bandolibre/bandolibre.github.io/models/BandoNeo - Key - 72.3mf

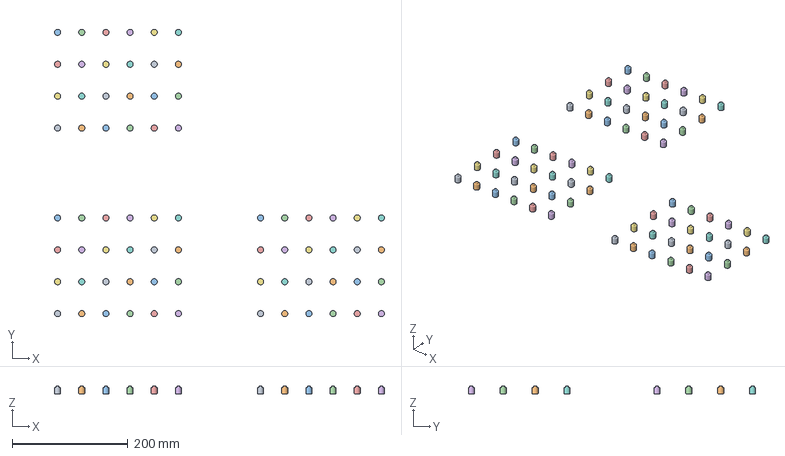
[picture p9: CAD file, 2026-06-30]
models/BandoNeo - Key - 72.3mf
569.0 x 495.7 x 14.0 mm
