bandolibre/bandolibre.github.io/models/BandoNeo - Key - slice.3mf

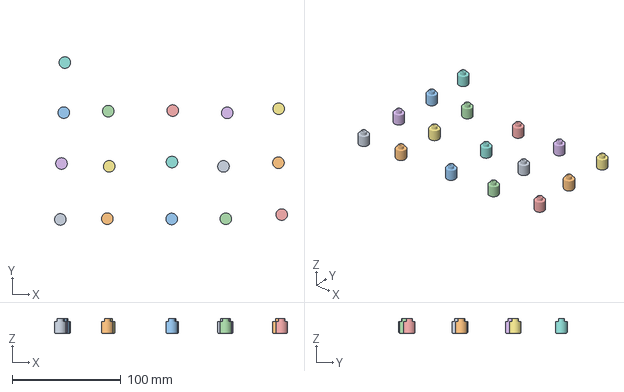
[picture p10: CAD file, 2026-06-30]
models/BandoNeo - Key - slice.3mf
214.0 x 154.8 x 14.0 mm
