bandolibre/bandolibre.github.io/code/main-g474/Core/Src/main.c

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
/* Includes ------------------------------------------------------------------*/
#include "main.h"

/* USER CODE BEGIN Includes */
#include <stdio.h>
#include <stdlib.h>
#include <string.h>
#include "console.h"
#include "swo.h"
#include "usb_app.h"
#include "app/bellow.h"
#include "app/buttons.h"
#include "app/keyboard.h"
#include "app/pedals.h"
#include "app/report.h"
#include "properties.h"
#include "properties_console.h"
#include "app/midi.h"
#include "app/app.h"

/* USER CODE END Includes */

ADC_HandleTypeDef hadc1;
ADC_HandleTypeDef hadc2;
ADC_HandleTypeDef hadc3;
ADC_HandleTypeDef hadc4;

SPI_HandleTypeDef hspi1;
SPI_HandleTypeDef hspi2;
DMA_HandleTypeDef hdma_spi1_rx;
DMA_HandleTypeDef hdma_spi2_rx;

UART_HandleTypeDef huart1;

PCD_HandleTypeDef hpcd_USB_FS;

void SystemClock_Config(void);
static void MX_GPIO_Init(void);
static void MX_DMA_Init(void);
static void MX_ADC1_Init(void);
static void MX_ADC2_Init(void);
static void MX_ADC3_Init(void);
static void MX_ADC4_Init(void);
static void MX_SPI1_Init(void);
static void MX_SPI2_Init(void);
static void MX_USART1_UART_Init(void);
static void MX_USB_PCD_Init(void);
/* USER CODE BEGIN 0 */

int console_execute(int argc, const char * const *argv)
{
  if (argc == 0)
    return 0;
  /* microrl ends the input line with LF only (no CR), leaving the cursor under
   * the command text. Return to column 0 so output prints cleanly below the
   * preserved "IRin > <cmd>" line instead of overwriting it. */
  printf("\r\n");
  if (strcmp(argv[0], "hello") == 0)
  {
    printf("Hello, Bandolibre!\r\n");
  }
  else if (strcmp(argv[0], "midi") == 0)
  {
    /* midi [note]: send a test note on/off pair over USB MIDI (default A4) */
    uint8_t note = (argc > 1) ? (uint8_t)atoi(argv[1]) : 69;
    usb_app_midi_test_note(note);
    printf("Sent MIDI note %u on/off\r\n", note);
  }
  else if (strcmp(argv[0], "bellow_tune") == 0) bellow_tune();
  else if (strcmp(argv[0], "help") == 0)   { properties_help(); midi_console_help(); }
  else if (properties_execute(argc, argv)) { /* handled show/get/set/reset */ }
  else if (midi_console_execute(argc, argv)) { /* handled a send_* command */ }
  else
    printf("Unknown command: %s (try 'help')\r\n", argv[0]);
  return 0;
}

/* Tab-completion for microrl: completes the command word, and the property name
 * argument of get/set/reset. Returns a NULL-terminated array of full tokens.
 * property_complete() caps its output at the buffer size, so growth is safe. */
#define CONSOLE_COMPL_MAX 32
char ** console_complete(int argc, const char * const *argv)
{
  static const char *commands[] = { "help", "show", "get", "set", "reset", "hello", "midi", "bellow_tune" };
  static char *out[CONSOLE_COMPL_MAX + 1];
  const char *partial = (argc > 0) ? argv[argc - 1] : "";
  size_t n = 0;

  if (argc <= 1)
  {
    size_t plen = strlen(partial);
    for (size_t i = 0; i < sizeof(commands) / sizeof(commands[0]); i++)
      if (strncmp(commands[i], partial, plen) == 0)
        out[n++] = (char *)commands[i];
    const char *midi[CONSOLE_COMPL_MAX];
    size_t m = midi_console_complete(partial, midi, CONSOLE_COMPL_MAX - n);
    for (size_t i = 0; i < m; i++)
      out[n++] = (char *)midi[i];
  }
  else if (argc == 2 && (strcmp(argv[0], "get") == 0 ||
                         strcmp(argv[0], "set") == 0 ||
                         strcmp(argv[0], "reset") == 0))
  {
    const char *names[CONSOLE_COMPL_MAX];
    size_t m = properties_complete(partial, names, CONSOLE_COMPL_MAX);
    for (size_t i = 0; i < m; i++)
      out[n++] = (char *)names[i];
  }
  out[n] = NULL;
  return out;
}

/* USER CODE END 0 */

/**
  * @brief  The application entry point.
  * @retval int
  */
int main(void)
{

  /* MCU Configuration--------------------------------------------------------*/

  /* Reset of all peripherals, Initializes the Flash interface and the Systick. */
  HAL_Init();

  /* Configure the system clock */
  SystemClock_Config();

  /* Initialize all configured peripherals */
  MX_GPIO_Init();
  MX_DMA_Init();
  MX_ADC1_Init();
  MX_ADC2_Init();
  MX_ADC3_Init();
  MX_ADC4_Init();
  MX_SPI1_Init();
  MX_SPI2_Init();
  MX_USART1_UART_Init();
  MX_USB_PCD_Init();
  /* USER CODE BEGIN 2 */
  main_init();
  /* USER CODE END 2 */

  /* Infinite loop */
  /* USER CODE BEGIN WHILE */
  while (1)
  {
    /* USER CODE END WHILE */

    /* USER CODE BEGIN 3 */
    main_task();
  }
  /* USER CODE END 3 */
}

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
