bandolibre/bandolibre.github.io/code/main-g474/main-g474.ioc

Mcu.UserName=STM32G474CBTx
PA0.GPIO_Label=EXP_PEDAL
PA0.Signal=ADC1_IN1
PA1.GPIO_Label=SUS_PEDAL
PA1.Signal=ADC2_IN2
PA10.Signal=USART1_RX
PA11.GPIO_Label=USB_DM
PA11.Signal=USB_DM
PA12.GPIO_Label=USB_DP
PA12.Signal=USB_DP
PA13.Signal=SYS_JTMS-SWDIO
PA14.Signal=SYS_JTCK-SWCLK
PA15.GPIO_Label=PGM_DETECT
PA15.Signal=GPIO_Input
PA2.GPIO_Label=HALL_NEN
PA2.Signal=GPIO_Output
PA3.GPIO_Label=L_BOOT0
PA3.Signal=GPIO_Output
PA4.GPIO_Label=L_SPI_NSS
PA4.Signal=SPI1_NSS
PA5.GPIO_Label=L_SPI_SCK
PA5.Signal=SPI1_SCK
PA6.GPIO_Label=L_SPI_MISO
PA6.Signal=SPI1_MISO
PA7.GPIO_Label=L_SPI_MOSI
PA7.Signal=SPI1_MOSI
PA8.GPIO_Label=R_READY
PA8.Signal=GPIO_Input
PA9.Signal=USART1_TX
PB0.GPIO_Label=L_READY
PB0.Signal=GPIO_Input
PB1.GPIO_Label=HALL0
PB1.Signal=ADC3_IN1
PB11.GPIO_Label=R_NRST
PB11.Signal=GPIO_Output
PB12.GPIO_Label=HALL1
PB12.Signal=ADC4_IN3
PB13.GPIO_Label=R_BOOT0
PB13.Signal=GPIO_Output
PB14.GPIO_Label=R_SPI_MISO
PB14.Signal=SPI2_MISO
PB15.GPIO_Label=R_SPI_MOSI
PB15.Signal=SPI2_MOSI
PB2.GPIO_Label=L_NRST
PB2.Signal=GPIO_Output
PB3.Signal=SYS_JTDO-SWO
PB4.GPIO_Label=SW_FN2
PB4.Signal=GPIO_Input
PB5.GPIO_Label=LED_FN2
PB5.Signal=GPIO_Output
PB6.GPIO_Label=SW_FN1
PB6.Signal=GPIO_Input
PB7.GPIO_Label=LED_FN1
PB7.Signal=GPIO_Output
PB8-BOOT0.GPIO_Label=SW_FN0_BOOT0
PB8-BOOT0.Signal=GPIO_Input
PB9.GPIO_Label=LED_FN0
PB9.Signal=GPIO_Output
PC14-OSC32_IN.GPIO_Label=EXP_PEDAL_INT
PC14-OSC32_IN.Signal=GPIO_Input
PC15-OSC32_OUT.GPIO_Label=SUS_PEDAL_INT
PC15-OSC32_OUT.Signal=GPIO_Input
PF0-OSC_IN.GPIO_Label=R_SPI_NSS
PF0-OSC_IN.Signal=SPI2_NSS
PF1-OSC_OUT.GPIO_Label=R_SPI_SCK
PF1-OSC_OUT.Signal=SPI2_SCK
