bandolibre/bandolibre.github.io/code/main-g474/app/pedals.c

#include "pedals.h"

#include <stdio.h>

#include "hysteresis.h"
#include "keyboard.h"   /* L_MIDI_CH / R_MIDI_CH */
#include "main.h"
#include "properties.h"
#include "usb_app.h"

/* ADC handles for the two pedal wipers, defined by the CubeMX-generated main.c:
 * ADC1 reads pedal 1 (expression), ADC2 pedal 2 (sustain). */
extern ADC_HandleTypeDef hadc1;
extern ADC_HandleTypeDef hadc2;

/* Each pedal's wiper is interpolated over its [min,max] property range to 0..127
 * and sent on this controller. Pedal 1 uses Modulation (CC#1) and pedal 2 the
 * Foot Controller (CC#4): both are pre-mapped in most instruments, so the
 * pedals do something out of the box, and either can still be MIDI-learned to a
 * different VST parameter in the DAW. */
#define PEDAL1_CC 1
#define PEDAL2_CC 4

/* Movement of the wiper sample (out of the 12-bit ADC range) that must be
 * exceeded before a new diagnostic line is logged, so wiper noise on a
 * connected pedal doesn't flood the console. */
static const uint32_t PEDAL_WIPER_HYST = 16;

/* Per-pedal state retained across polls: the directional-hysteresis state that
 * cleans the wiper into a 0..127 CC, plus separate state for the diagnostic
 * log line. */
typedef struct {
  hyst_state_t hyst;        /* sample -> CC hysteresis/rate-limit state */
  uint8_t  connected_prev;  /* connected flag at the last logged line (0xFF = none yet) */
  uint32_t sample_prev;     /* wiper sample at the last logged line */
} pedal_state_t;

/* Polls one pedal: logs detect/movement changes, and while a pedal is connected
 * runs the wiper through directional hysteresis (see hysteresis.h) and emits its
 * Effect Controller CC whenever hyst_update() says the cleaned value is worth
 * sending. The detect line is pulled high in the no-pedal state (a normally-closed
 * jack switch biases it to VCC), so a connected pedal reads GPIO_PIN_RESET. */
static void pedal_poll_one(const char *name, GPIO_TypeDef *det_port, uint16_t det_pin,
                           ADC_HandleTypeDef *adc, uint8_t controller,
                           const hyst_config_t *cfg, pedal_state_t *st)
{
  uint8_t connected = HAL_GPIO_ReadPin(det_port, det_pin) == GPIO_PIN_RESET;
  uint32_t sample = HAL_ADC_GetValue(adc);

  /* Always log a presence change; otherwise only when log_pedals is set and the
   * wiper has moved enough to be worth a line. */
  uint32_t delta = sample > st->sample_prev ? sample - st->sample_prev : st->sample_prev - sample;
  if (connected != st->connected_prev ||
      (g_properties->log_pedals && connected && delta > PEDAL_WIPER_HYST))
  {
    st->connected_prev = connected;
    st->sample_prev = sample;
    printf("%s connected=%u val=%u\r\n", name, connected, (unsigned)sample);
  }

  /* Only stream the controller while a pedal is plugged in; the detect line
   * floats otherwise. Resending starts fresh on reconnect (reseed the filter
   * and anchor from the first sample after plug-in). */
  if (!connected)
  {
    st->hyst.init = false;
    return;
  }

  uint8_t value;
  if (!hyst_update(&st->hyst, cfg, sample, HAL_GetTick(), &value)) return;
  /* Mirror the bellows expression CC: send on both keyboard channels so the
   * mapping works regardless of which channel the DAW listens on. */
  usb_app_midi_control_change(L_MIDI_CH, controller, value);
  usb_app_midi_control_change(R_MIDI_CH, controller, value);
}

void pedals_poll(void)
{
  static pedal_state_t pedal1 = { {0}, 0xFF, 0xFFFF };
  static pedal_state_t pedal2 = { {0}, 0xFF, 0xFFFF };

  /* Built per poll from g_properties so edits take effect live; hyst_update() is
   * inlined, so these structs scalarize away rather than hitting the stack. */
  hyst_config_t cfg1 = {
    .in_min = g_properties->pedal1_min, .in_max = g_properties->pedal1_max, .out_max = 127,
    .fwd_thresh = g_properties->pedal1_hyst_fwd, .rev_thresh = g_properties->pedal1_hyst_rev,
    .ema_alpha = g_properties->pedal1_ema_alpha, .min_period_ms = g_properties->pedal1_cc_period_ms,
  };
  hyst_config_t cfg2 = {
    .in_min = g_properties->pedal2_min, .in_max = g_properties->pedal2_max, .out_max = 127,
    .fwd_thresh = g_properties->pedal2_hyst_fwd, .rev_thresh = g_properties->pedal2_hyst_rev,
    .ema_alpha = g_properties->pedal2_ema_alpha, .min_period_ms = g_properties->pedal2_cc_period_ms,
  };

  /* Start both conversions before reading either, so they run concurrently on
   * ADC1/ADC2 rather than back to back. pedal_poll_one() reads the results. */
  HAL_ADC_Start(&hadc1);
  HAL_ADC_Start(&hadc2);
  HAL_ADC_PollForConversion(&hadc1, 1);
  HAL_ADC_PollForConversion(&hadc2, 1);

  pedal_poll_one("PEDAL1", EXP_PEDAL_INT_GPIO_Port, EXP_PEDAL_INT_Pin, &hadc1,
                 PEDAL1_CC, &cfg1, &pedal1);
  pedal_poll_one("PEDAL2", SUS_PEDAL_INT_GPIO_Port, SUS_PEDAL_INT_Pin, &hadc2,
                 PEDAL2_CC, &cfg2, &pedal2);
}
