bandolibre/bandolibre.github.io/(commit log)

2026-06-13 Increase board label and license size.
2026-06-14 Add SPI stat property
2026-06-15 Add hall tunning and oversample hall
2026-06-15 Set note velocity from bellow instensity.
2026-06-15 Fix keyboard layout in generated code.
    [keyboard.c]
2026-06-16 Add directionnal backlash filtering
    [hysteresis.h, hysteresis_test.c, pedals.c]
2026-06-16 Factor out buttons polling.
2026-06-16 [board] fix pulldown resistor. 100k was too little.
2026-06-18 Increase SWO buffer to avoid truncating long lines.
    [swo.c]
2026-06-19 Simplify SPI DMA rearm code.
    The DMA is alwayse configured by generated code.
2026-06-19 Simplify and improve SPI buffer flow.
    Introduce triple buffer, and simplify DMA triggering.
2026-06-20 Better device naming on Windows
2026-06-20 Fix console and stop relying on all notes off signal.
    [config.h, console.c, console.h, keyboard.cpp, main.c]
2026-06-20 Move wing logic out of generated file.
2026-06-20 updates all board matching in the register.
    [boards.csv]
2026-06-20 Minor simplification of wing code.
2026-06-20 Fix `just midimon` to use the right device name.
2026-06-20 Reorganize wing code and save memcpy
2026-06-20 Fix wing console and layout code.
    [app.cc, console.c]
2026-06-20 Fix wing reports
2026-06-21 Report bellow modeling on swo traces.
2026-06-22 Remove obsolete material, gridpaper and solver.
2026-06-30 Disable bellow simulation by default and fix range.
    [buttons.c]
2026-06-30 Write a script for button layouts.
    [BandoNeo - Key - 72.3mf, BandoNeo - Key - slice.3mf]
2026-06-30 Add cables to the bom.
2026-07-01 Start step to step assembly
2026-07-03 Add all 1.0-alpha to board database.
    [boards.csv]
2026-08-04 Rename to assembly instructions.
2026-08-04 Document board programming.
2026-08-04 Assembly documentation up to programming all boards.
2026-08-09 Switch to monorepo worktree.
2026-08-10 Cleanup unused or obsolete content.
    [BOM_MainBoard_MainBoard.csv, BOM_WingLeft_WingLeft.csv, BOM_WingRight_WingRight.csv]
